LunguJean/ORCAD-Project/P1_2025_434A_Lungu_Jean_PAI_Capitolul5_N1_Simulator/P1_2025_434A_Lungu_Jean_PAI_N1_OrCAD/5_Preampl de intr.pdf

### Capitolul 5

### PREAMPLIFICATOR AUDIO DE INTRARE

Acest capitol prezintă principalele aspectele ale proiectării preamplificatorului audio de intrare destinat adaptării la intrare cu tipurile uzuale de surse de semnal, iar la ieşire cu un etaj corector de ton sau alt etaj intermediar sau chiar direct cu amplificatorul de putere.

### 5.1 TEMA DE PROIECTARE

Tema de proiectare se referă la un preamplificator de audiofrecvenţă de intrare având schema bloc prezentată în Figura 5.1-1.. Amplificatorul audio de intrare este compus din o reţea de adaptare la intrare cu principalele surse de semnale audio (microfon, pick-up cu doză magnetică, pick-up cu doză ceramică, radio, magnetofon sau alte ieşiri de semnal ale aparatelor audio electronice) şi două etaje de amplificare în clasa A, respectiv etajul de intrare şi etajul de ieşire care realizează amplificarea în tensiune a semnalului.
Amplificarea globală a amplificatorului audio de intrare este stabilită de reacţie negativă serie la intrare-paralel la ieşire iar alimentarea celor două etaje de amplificare este realizată de sursa de alimentare.

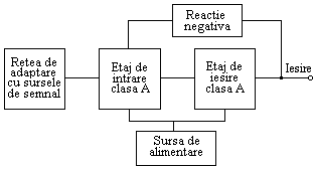
[picture p2: figure]

Figura 5.1-1. Schema bloc a amplificatorului audio de intrare

132 | Proiectarea circuitelor electronice de audiofrecvenţă

### 5.2 SETURI DE DATE DE INTRARE

Principalii parametri ai amplificatorului audio de intrare sunt: Sensibilitatea minimă la intrare Vin (mV)
Rezistenţa de intrare Ri (K )
Rezistenţa de ieşire maximă R0M (K )
Tensiunea nominală la ieşirea amplificatorului audio de putere Vn (Vef)

Sursa de alimentare va asigura următorii parametri:
Curentul nominal Io (mA)
Rezistenţa de ieşire maximă R0M ( )

Coeficientul de stabilizare
V Rs ct

V
S

I

0

0

S0min

Tensiunea de alimentare este 220Vac 10%

Tabelul 5.2-1. Seturi de date de intrare pentru proiectare
Nr. | Preamplificator | Sursa de alimentare
Vin (mV) | Ri (K ) | R0M (K ) | Vn (Vef) | Io (mA) | R0M ( ) | S0min (-)
1 | 2,5 | 47 | 3 | 1,5 | 10 | 5 | 100
2 | 5 | 47 | 3 | 1,5 | 10 | 5 | 100
3 | 100 | 100 | 3 | 1,5 | 10 | 5 | 100
4 | 200 | 1000 | 3 | 1,5 | 10 | 5 | 100
5 | 2,5 | 47 | 4 | 1,4 | 12 | 6 | 80
6 | 5 | 47 | 4 | 1,4 | 12 | 6 | 80
7 | 100 | 100 | 4 | 1,4 | 12 | 6 | 80
8 | 200 | 1000 | 4 | 1,4 | 12 | 6 | 80
9 | 2,5 | 47 | 5 | 1,3 | 14 | 7 | 60
10 | 5 | 47 | 5 | 1,3 | 14 | 7 | 60
11 | 100 | 100 | 5 | 1,3 | 14 | 7 | 60
12 | 200 | 1000 | 5 | 1,3 | 14 | 7 | 60
13 | 2,5 | 47 | 6 | 1,2 | 16 | 8 | 50
14 | 5 | 47 | 6 | 1,2 | 16 | 8 | 50
15 | 100 | 100 | 6 | 1,2 | 16 | 8 | 50
16 | 200 | 1000 | 6 | 1,2 | 16 | 8 | 50
17 | 2,5 | 47 | 7 | 1,1 | 18 | 9 | 40
18 | 5 | 47 | 7 | 1,1 | 18 | 9 | 40
19 | 100 | 100 | 7 | 1,1 | 18 | 9 | 40
20 | 200 | 1000 | 7 | 1,1 | 18 | 9 | 40

Preamplificator audio de intrare | 133

Setul de date utilizate pentru exemplificare

Pentru proiectarea etajelor amplificatorului audio de intrare a fost utilizat setul de parametri următor:

Tabelul 5.2-2. Setul de date utilizate pentru exemplificare
Nr. | Preamplificator | Sursa de alimentare
Vin (mV) | Ri (K ) | R0M (K ) | Vn (Vef) | Io (mA) | R0M ( ) | S0min (-)
1 | 2,5 | 47 | 3 | 1,5 | 10 | 5 | 100
2 | 5 | 47 | 3 | 1,5 | 10 | 5 | 100
3 | 100 | 100 | 3 | 1,5 | 10 | 5 | 100
4 | 200 | 1000 | 3 | 1,5 | 10 | 5 | 100

### 5.3 SCHEMA ELECTRONICĂ

Preamplificatorul este partea care influenţează cel mai pregnant raportul semnal zgomot, caracteristica de frecvenţă şi factorul de distorsiuni într-un lanţ de amplificare de audiofrecvenţă.
În practică există adesea şi alte semnale numite semnale false, care tind să interfereze cu semnalele dorite şi acestea se numesc în general semnale de zgomot. Un obiectiv important în proiectare este realizarea unui bun raport semnal zgomot, cu toate că zgomotul nu poate fi eliminat complet.
Un preamplificator sensibil si relativ puţin zgomotos constituie o problemă importantă dacă urmează ca la ieşire zgomotul să fie minim, deoarece orice zgomot din preamplificator este amplificat de fiecare etaj care urmează.
Din aceste considerente pentru intrarea de pick-up cu doză magnetică şi microfon dinamic la care nivelul semnalului de intrare precum şi raportul semnal zgomot sunt minime, au fost prevăzute filtre de compensare care acţionează prin intermediul sistemului de reacţie negativă, Figura 5.3-1..
Reţeaua de adaptare la intrare cu diverse surse de semnal este alcătuită din divizoarele R11, R12 pentru intrarea de radio şi magnetofon şi R13, R14 pentru intrarea de pick-up cu doză de tip piezoelectric.
Amplificarea în tensiune este realizată de etajul de intrare şi cel de ieşire. Etajul de intrare este de tipul emitor comun cu sarcină distribuită şi este realizat cu tranzistorul T1.
Etajul de ieşire este cuplat galvanic cu etajul de intrare şi este de tip emitor comun, realizat cu tranzistorul T2.
Comutarea de la o categorie de surse de semnal la alta se face prin schimbarea atenuatorilor de intrare şi a reţelei de reacţie pentru ajustarea amplificării la nivelul corespunzător.

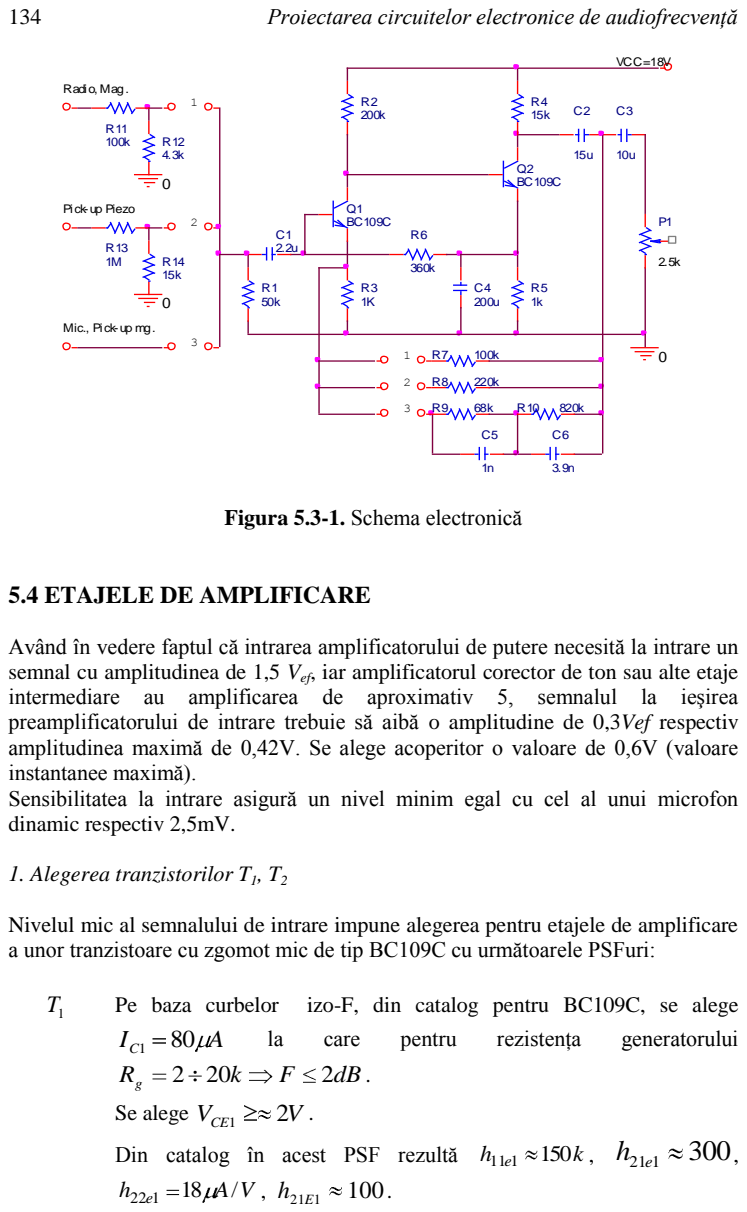
[picture p3: page 4]

Mic., Pick-up mg.

Având în vedere faptul că intrarea amplificatorului de putere necesită la intrare un
semnal cu amplitudinea de 1,5 Vef, iar amplificatorul corector de ton sau alte etaje
intermediare au amplificarea de aproximativ 5, semnalul la ieşirea
preamplificatorului de intrare trebuie să aibă o amplitudine de 0,3Vef respectiv
amplitudinea maximă de 0,42V. Se alege acoperitor o valoare de 0,6V (valoare
instantanee maximă).
Sensibilitatea la intrare asigură un nivel minim egal cu cel al unui microfon
dinamic respectiv 2,5mV.

Nivelul mic al semnalului de intrare impune alegerea pentru etajele de amplificare
a unor tranzistoare cu zgomot mic de tip BC109C cu următoarele PSFuri:

Din catalog în acest PSF rezultă

Preamplificator audio de intrare | 135

T2
Pentru T2 se alege

IC2 1mA
şi

VCE2 5V
. Din catalog în acest PSF

rezultă:

h | k 11e2
15 , | h21e2
400 ,

h22e2

55 A/V , h21E2
300 .
2. Amplificarea în tensiune

Amplificarea în tensiune a etajului de intrare care este de tipul emitor comun cu sarcină distribuită este:

3

2

1
11 2 22 1
1
R
h | h | R
A
| e | e
VT

Considerând

R | h e | h e
| | 1
2 | 11 2 | 22 1
3 | 3 | 3

1
11 2 22 1
1
15 | 55 | 12
| | R k
| R
k | k
R

h h
A
e | e
VT

Pentru obţinerea unor distorsiuni tranzitorii mici se impune o amplificare redusa, cu reacţie locală Av,T1 -10.
Din acest considerent se alege
R 1k 3

Din condiţiile:

R | h e | h e

1
2 | 11 2 | 22 1

şi

VCE1 | EC
( R2 | R3
)IC1 | 2V ,

se aleg

R 200k 2
si

EC 18V .
Se poate calcula exact VCE1:
C | 2 | C1 | B2 | CE1 | 3 C1 E | R (I | I ) V | R I
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
21 2

2
2

VCE1

18V 200k | 83 A 1k | 80 A 1,32V
şi este mai mare ca amplitudinea semnalului la ieşirea etajului de intrare. Considerând

VR2 R2

(IC1

IB2

) 16,6V
şi aproximând
VBE2 | 0,6V
VR5 | EC | VR2 | VBE2 | 0,8V .

Se alege

R5 | 1k | IC2 | 0,8mA.

Ecuaţia dreptei de sarcină pentru
2 | 4 | 5 | 2 | 2
: | ( | ) C | C | VCE T E | R | R I

, k
, mA
V | , V | V
I
E | V | V
R

C

C | R | CE | 15 25
0 8
18 | 0 8 | 5

2

5 | 2
4

,

se adoptă
R 15k 4

Amplificarea în tensiune a etajului de ieşire este:

136 | Proiectarea circuitelor electronice de audiofrecvenţă

47
55 | 15
( | ) | ( | ) | 400(15 | 18 )

11 2

1
22 1

1
21 2 | 4 | 22 2

11 2

1
21 2 | 4 | 22 2
2
k | k
k | k
h | h
h | R | h
R | h
h | R | h
A
e | e
e | e
g | e
e | e
VT

Amplificarea în tensiune a etajului de intrare este:

7,9
450

11,8 300
( | 1)
( | )

21 1
11 1 | 21 1 | 3

2

1
11 2 22 1
1
k

k
h
h | h | R
h | h | R
A | e
e | e
e | e
VT

Amplificarea în tensiune a preamplificatorului în buclă deschisă este:

AV | AVT1 AVT2
| | 7,9 47 371
3. Impedanţa de intrare

Impedanţa de intrare în buclă deschisă a preamplificatorului este:

1 | 11 1 | 21 1 | 3 | 6 ZInT | (h e
(h e | 1)R ) | R
R6
se dimensionează având în vedere necesitatea polarizării bazei tranzistorului T1
:
R6
IB1 | VR5 | VBE,T1 | VR3

0,8 0,43 0,08 0,29V

cu
A
h

I
I

E

C
B | 0,8
100

80

21 1

1
1

K
A

V
R | 362
0,8

0,29
6

se alege
R 360k 6

ZInT1

(150K 300K) | 360K | 200K
4. Dimensionarea condensatorilor

Din motive de stabilitate determinate grafic pe caracteristica BODE, se alege pentru polul dat de

C4
la frecvenţa
5 10 | (7 | ) f
4 | Hz Hz p

Rezistenţa văzută la bornele lui

C4
este:

1 126
400

15 43

21 2

1
11 2 | 2 | 22 1
4 | 5 | K
k | K
h
h | R | h
R | R
| e
e | e
C p

F
f R

C

p C p

180
2

1

4 | 4

4

, se alege
C4

200 F

Având în vedere că

R1
se alege astfel încât impedanţa văzută spre amplificator să fie

47k
, necesară pentru adaptarea cu doza magnetică şi alegând f 1,5Hz 1

Preamplificator audio de intrare | 137

, F
,
C | 2 2
2 15 47 10

1

1 | 3

Pentru dimensionarea C2 se apreciază că impedanţa la bornele sale nu va fi mai mică de 50K având în vedere efectul potenţiometrului de balans şi al reţelei de reacţie. Se alege
f 0,2Hz 2

, F
f R

C

C

15 9
2

1

2 | 2

2

, se alege

C2 15 F .

Impedanţa de ieşire a preamplificatorului fără reacţie negativă este:
Z | R | h | k | k | k IesT | e
15 | 18 | 8,2

1
2 | 4 | 22 2
Cu reacţie negativă având în vedere necesitatea de amplificare pentru o valoare medie r = 100⁻¹
,

Impedanţa de ieşire
, K
,

, K
A

Z
Z

r u

IesT
Ies | 2 2
3 71

2 8 2

Se poate accepta ca valoare minima a lui

P1
25
K , valoarea maximă de
aproximativ 100 K e impusă de intrarea în circuitul corector de ton. Valoarea lui

C3
s-a ales de
C3 10 F

pentru P1 =25 K .

### 5.5 REACŢIA NEGATIVĂ ŞI REŢELELE DE ADAPTARE

Pentru estimarea nivelului nominal al semnalului la ieşirea preamplificatorului cunoaştem:
Amplitudinea nominală a semnalului la intrarea în amplificatorul final
Vnom. aap = 1,5Vef
Amplificarea circuitelor intermediare de aproximativ 5
Atenuarea introdusă de P1 = 0,9

ef

ef
iesire pa | mV

V
V | 330
5 0,9

1,5

,

Reţelele de adaptare se dimensionează în raport cu acest nivel şi nivelele tipice ale surselor de program. S-au adoptat următoarele categorii de surse de semnal corespunzătoare cu tema de proiectare:

Tabelul 5.5-1. Caracteristicile surselor de semnal uzuale
Sursa | Rezistenţa de intrare Ri (K ) | Sensibilitate Vin (mV)
Radio, magnetofon | 100K | 100mVef
Pick-up ceramic | 1M | 200mVef
Pick-up magnetic | 47K | 5mVef, la 1KHz
Microfon | 47K | 2,5mVef

138 | Proiectarea circuitelor electronice de audiofrecvenţă

Alegerea reţelei de reacţie serie la intrare–paralel la ieşire creşte impedanţa de intrare şi micşorează impedanţa de ieşire, apropiind preamplificatorul audio de intrare de un amplificator ideal de tensiune. Experimental pentru un răspuns tranzitoriu bun

50 ¹
r
Dimensionarea reţelei de reacţie şi a reţelei de adaptare:
1. Dimensionarea pentru poziţia radio-magnetofon

Pentru poziţia radio-magnetofon se alege

R 100k 7
transferul pe bucla de
reacţie r=100⁻¹
, iar amplificarea cu reacţie este:

79
1 3,71

371

1 | r | V
| V
VR | A

A
A | .

Nivelul semnalului de intrare in preamplificator este:
mV mV UInT | 4,2
79

330

1
Deoarece nivelul semnalului la intrare pentru această sursă de semnal este Uin=100mV raportul de divizare al rezistenţelor R11, R12 este:

23
4,2

100

12 | 1

11

12

11 12
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
Deoarece

Z | k in | 100
, se alege
R | 100k 11 | 4,3 | .
12 R | k
2. Dimensionarea pentru poziţia microfon şi pick-up ceramic

Pentru poziţia microfon şi pick-up ceramic se utilizează reţeaua de reacţie, . R8 R3
Amplificatorul se calculează pentru nivelul minim de intrare dat de microfon:

132
2,5

330

1 | int | mV mV
| V V
A

A
A

rare

iesire

r V

V
VR | 221
| 1
4,5 10
132
132 | 3

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
r | 221 ³
8
8

3

8 | 3

3
. Se alege

R 220k 8

Dimensionarea divizorului de intrare pentru pick-up ceramic.

80
2,5

200

14 | , 1

13
mV

mV
V

V
R

R

In T

In

Din condiţia ca impedanţa de intrare să fie de aproximativ 1M , se alege
R13 | 1M | R | 12,5k 14
. Se alege

R 18k 14

Preamplificator audio de intrare | 139
3. Dimensionarea pentru poziţia microfon şi pick-up magnetic

Pentru intrarea de microfon şi pick-up magnetic se proiectează o reţea de reacţie egalizatoare, care să corecteze caracteristica de frecvenţă a dozei magnetice. S-a adoptat corecţia după norma R.I.A.A, în care se impun următoarele constante de timp: t1=318 s, t2=75 s, t3=3180 s.
Considerând o reacţie suficient de puternică astfel încât să se poată scrie:

r

AVr

1
şi având
Z

R

r

3
, unde Z( ) este impedanţa grupului format din R9,

R10, C5, C6
( )

3

K Z
R

Z
AVr

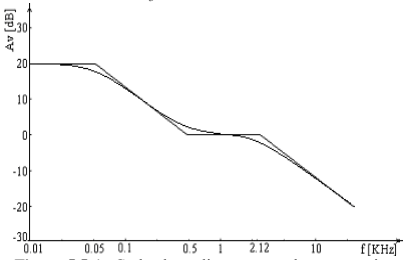
[picture p4: figure]

Figura 5.5-1. Curba de egalizare pentru doză magnetică

Z( ) este de forma:
(1 | )(1 | )

1

2 | 3

1
pt pt

pt
Z | B | ,

unde:
3 | 6 | 10
9 | 10
9 | 10
9 | 10 | 2 | 5 | 9 | 1 | 5 | 6
; | ; | ( | ) | ; t | C R
R | R

R R
B | R | R | t | C R | t | C | C

şi

10 | 9 | 6 | 4 5 R | 11,8R ; C | 3, C .

Practic la 1KHz se poate considera

Z R9
şi atunci

3

9
,1
R

R
AVr KHz

Amplificarea necesară este: 66
5

330

,1 | mV
mV AVr KHz R | R A | k 9 | 3 | Vr,1KHz | 66 | .

Se adoptă

R9 | 68K | R10 | 11,8R9 | 803K .

Se adoptă

R10 820K .

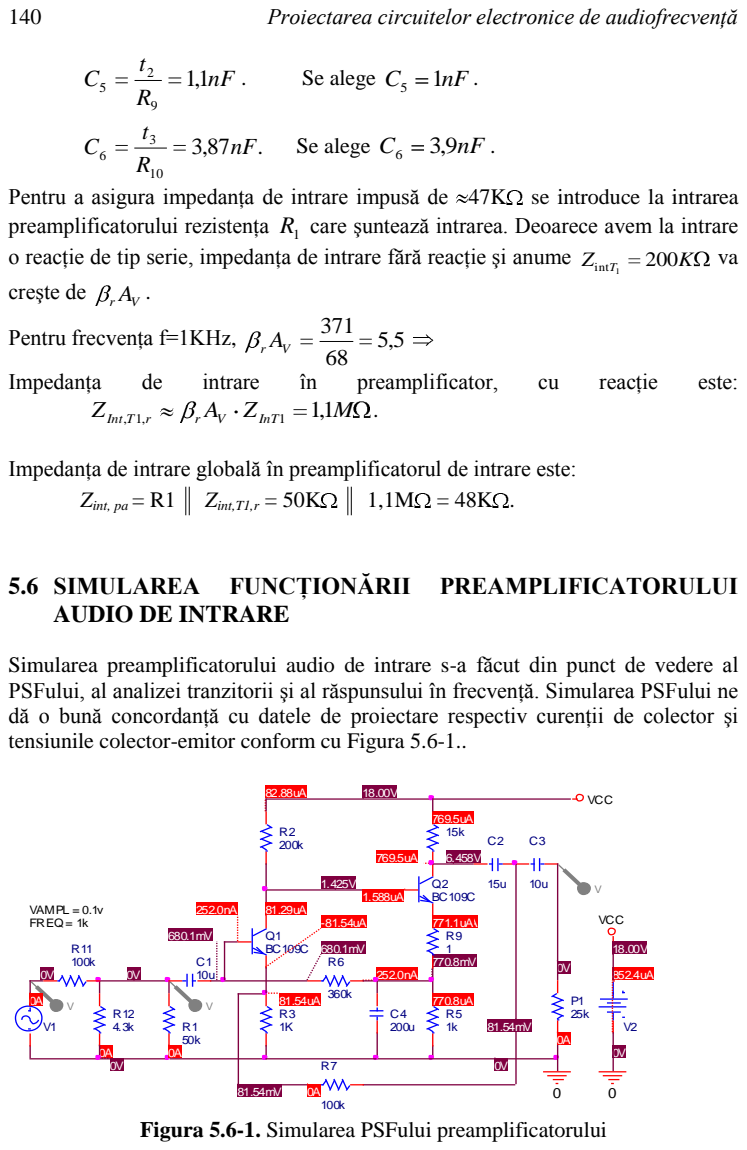
[picture p5: page 10]

preamplificatorului rezistenţa
o reacţie de tip serie, impedanţa de intrare fără reacţie şi anume
creşte de

care şuntează intrarea. Deoarece avem la intrare

Impedanţa de intrare globală în preamplificatorul de intrare este:

Simularea preamplificatorului audio de intrare s-a făcut din punct de vedere al
PSFului, al analizei tranzitorii şi al răspunsului în frecvenţă. Simularea PSFului ne
dă o bună concordanţă cu datele de proiectare respectiv curenţii de colector şi
tensiunile colector-emitor conform cu Figura 5.6-1..

Figura 5.6-1. Simularea PSFului preamplificatorului

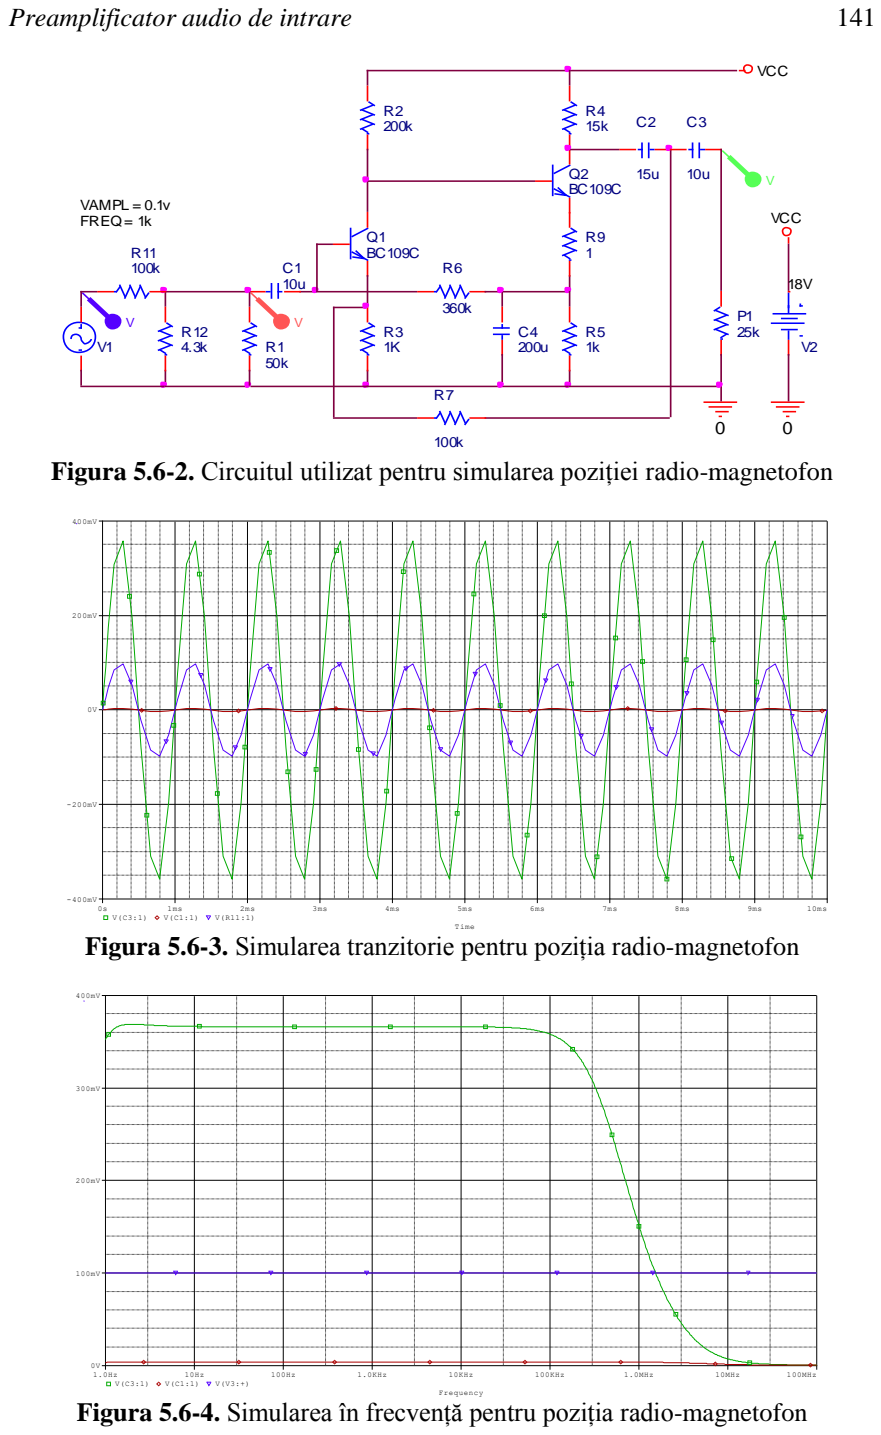
[picture p6: page 11]

Figura 5.6-2. Circuitul utilizat pentru simularea poziţiei radio-magnetofon

Figura 5.6-3. Simularea tranzitorie pentru poziţia radio-magnetofon

Figura 5.6-4. Simularea în frecvenţă pentru poziţia radio-magnetofon

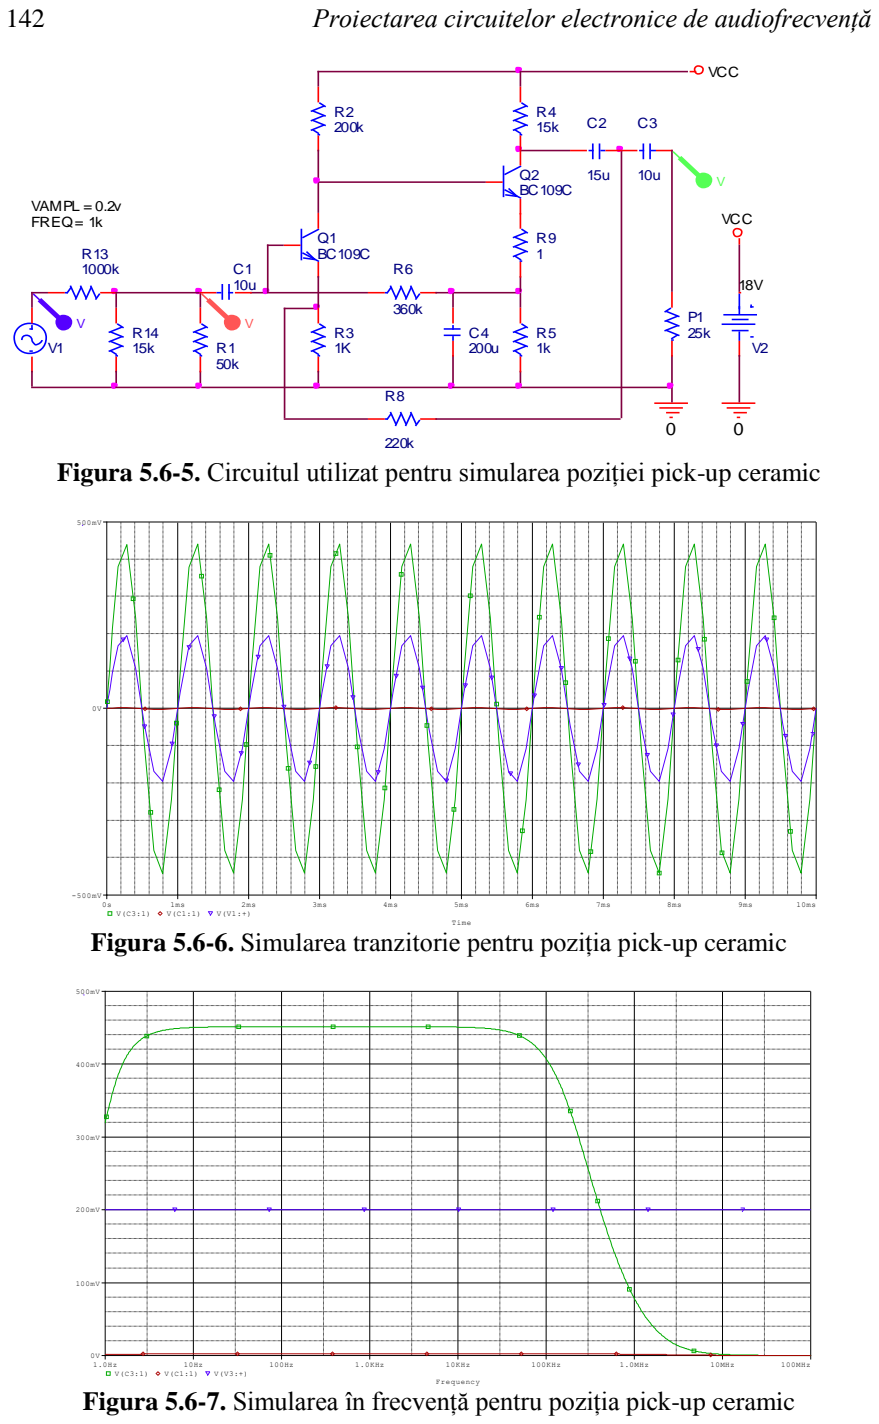
[picture p7: page 12]

Figura 5.6-5. Circuitul utilizat pentru simularea poziţiei pick-up ceramic

Figura 5.6-6. Simularea tranzitorie pentru poziţia pick-up ceramic

Figura 5.6-7. Simularea în frecvenţă pentru poziţia pick-up ceramic

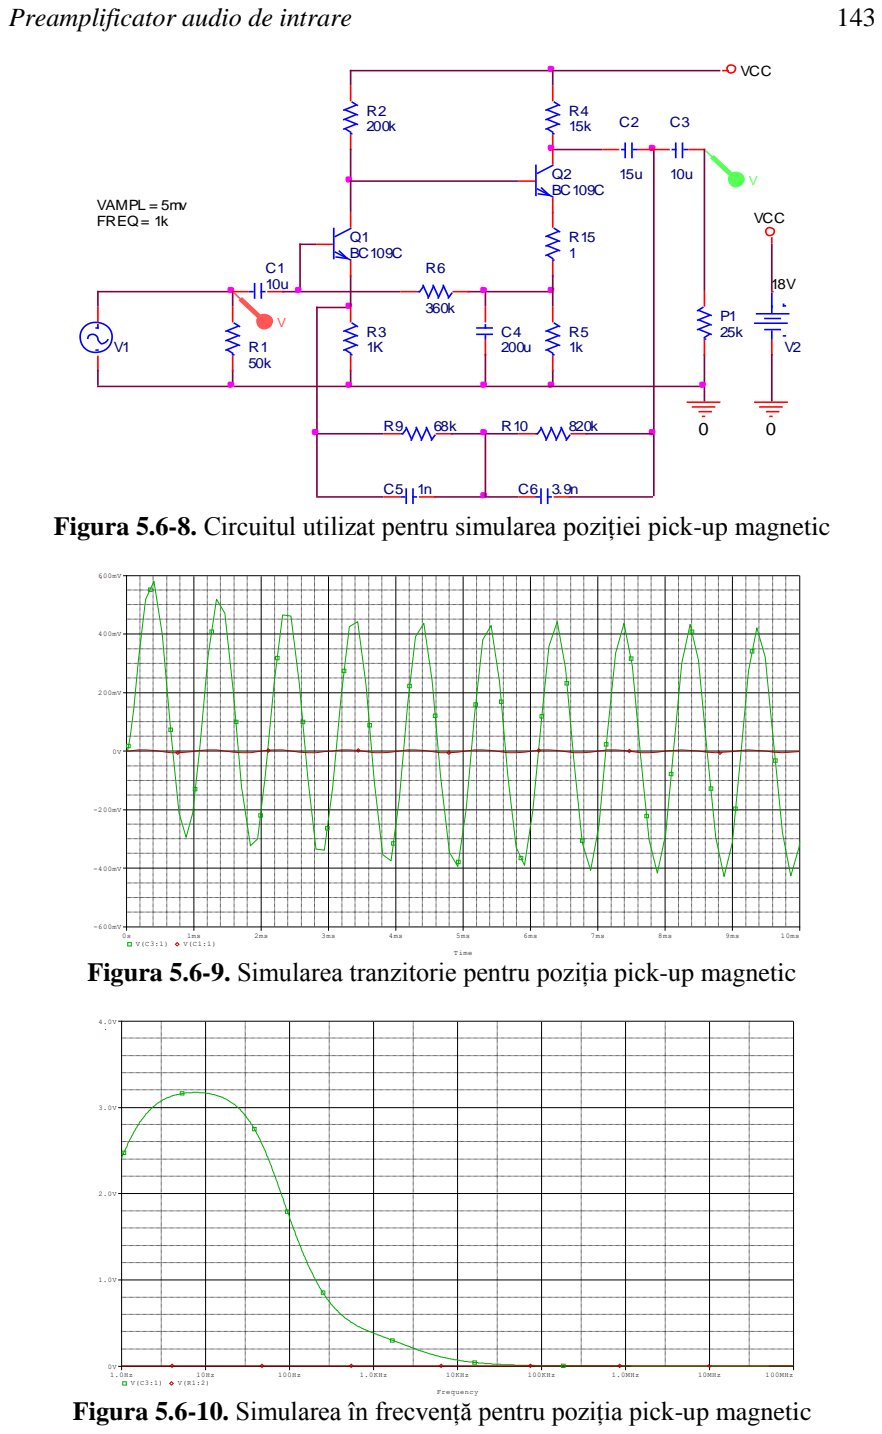
[picture p8: page 13]

Figura 5.6-8. Circuitul utilizat pentru simularea poziţiei pick-up magnetic

Figura 5.6-9. Simularea tranzitorie pentru poziţia pick-up magnetic

Figura 5.6-10. Simularea în frecvenţă pentru poziţia pick-up magnetic

144 | Proiectarea circuitelor electronice de audiofrecvenţă

### 5.7 SURSA DE ALIMENTARE

Alimentarea preamplificatorului audio şi a celui corector de ton se face din aceeaşi sursă.

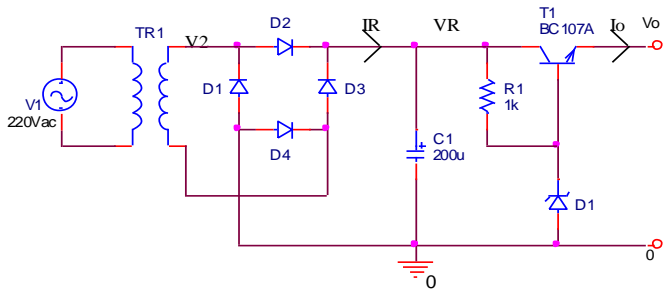
[picture p9: figure]
V1 220Vac

Figura 5.7-1. Sursa de alimentare a preamplificatorului audio

Conform temei de proiectare variaţiile tensiunii de alimentare sunt

10%
. Pentru
o tensiune medie la ieşirea redresorului VR=30V tensiunea maximă la ieşirea redresorului şi tensiunea minimă la ieşirea redresorului sunt VRM=33V şi VRm=27V.
Curentul de alimentare pentru două canale de preamplificare şi celelalte etaje intermediare se estimează la 10mA.

Proiectarea stabilizatorului

1. Alegerea tranzistorului regulator serie

Se alege tranzistorul T1=BC107A cu PSFul IC=10mA şi VCE=5V pentru care h21e 100.

2. Alegerea diodei stabilizatoare

Se alege dioda PL12V care are

I min | 2mA, PM | 100mW
| | | | | | | şi RZ=5 .
Se | conectează | în | serie | 2 | diode | şi se | consideră curentul maxim
admisibil
| I Max adm | | 9mA
, iar pentru curentul minim se alege

I min 3mA.
Din considerente de stabilitate a PSFului se verifică polarizarea bazei tranzistorului regulator serie T1.
B | dioda
E
C | mA | I

m
I
h

I
| 0,1
100

10

21

3. Dimensionarea rezistenţei R1

Dimensionarea rezistenţei R1 se face astfel ca la tensiunea de intrare minimă

Preamplificator audio de intrare | 145

aceasta să asigure funcţionarea diodei zener.

k
I | mA

V
R

Z min

min | 1
3

27 24

1

În condiţiile în care tensiunea de intrare este maximă, curentul prin dioda zener nu trebuie să depăşească curentul maxim admisibil.

mA
R | k

V
I

max
Z max | 9
1

33 24
=IMax adm=9mA.
4. Verificarea puterii disipate de tranzistorul regulator serie T1

Pentru verificarea puterii disipate de T1, în cazul cel mai defavorabil calculăm tensiunea colector-emitor când prin diodă trece curentul maxim de 10mA. În această situaţie tensiunea pe rezistenţa R1 esteVR1=9V. Deoarece VCB=VR VCE=VR+VBE=9,7V
Pd = VCE | IC = 97mW | 300mW.
5. Coeficientul de stabilizare cu tensiunea

Deoarece Vo= Vi
1
1 | 1
| 1

1
R
g | h | R
| | Z
m | oe

Vi
1

1

1
R

R

Z

V Rs ct

V
S

I

0

0 | 1

1
R

R

Z

=101

6. Rezistenţa de ieşire a stabilizatorului

Ro=
1
hie1 | R | RZ
1

hie1 RZ

40 10

100
40 1

1
I

h
C

ie

=0,25K

Ro=
101

250 10
=2,6

Proiectarea redresorului

1. Dimensionarea punţii redresoare

Pentru dimensionarea punţii redresoare calculăm tensiunea inversă şi curentul maxim prin aceasta:

146 | Proiectarea circuitelor electronice de audiofrecvenţă
Vinv | 1,5VR max | 50V
I max | 3,5I R max | 3,5 I 0 | I ZMax | 3,5(10 9) 67mA
Se alege o punte 1PM1 cu tensiunea inversă de 100V şi curentul mediu redresat de 1,2A.
2. Dimensionarea condensatorului de filtraj

Condensatorul de filtraj C1 se dimensionează utilizând inegalitatea:

R

R
V

, I
C

0 3
1 | F
V
, | mA
C | 160
30

0 3 16

1

Se alege C1 = 200 F/50V

3. Estimarea tensiunii şi curentului în secundarul transformatorului

Estimarea tensiunii şi curentului în secundarul transformatorului este necesară pentru dimensionarea numărului de spire şi diametrul înfăşurării secundare a transformatorului.

530

2
2 | 0 75
I ( R | | R )
V | , V
R | i | T
R

, unde:

Ri este rezistenţa corespunzătoare diodelor din puntea redresoare RT este rezistenţa corespunzătoare tranzistorului regulator serie R0 este rezistenţa de ieşire a redresorului

R

R
T
I

V
R ( 0,06 0,04 )R0

, R0

, V

mA V | , | V | 22 5
530
16 | 100
2 | 0 75 30
i | T

R
R
R R

, V
I | , | I
| | 2 16 6
2 | 1 41 | I
2 | 27,4mA

### 5.8 LISTA COMPONENTELOR

Lista componentelor amplificatorului audio de intrare

Rezistenţe

R1 = 50K | 5% | R2 = 200K | 5%
R3 = 1K | 2,5% | R4 = 15K | 5%
R5 = 1K | 5% | R6 = 360K | 5%

Preamplificator audio de intrare | 147
R7 = 100K | 2,5% | R8 = 220K | 2,5%
R9 = 68K | 2,5% | R10 = 820K | 2%
R11 = 100K | 2,5% | R12 = 4,3K | 2,5%
R13 = 1M | 2,5% | R14 = 13K | 2,5%
P1 = 25K | | EC = 18V

Condensatori

C1 = 2,2 F / 10V | C2 = 15 F / 15V
C3 = 10 F / 15V | C4 = 200 F / 10V
C5 = 1nF | 5% | C6 = 3,9nF | 5%

Tranzistori

T1, T2 = BC109C

Lista componentelor stabilizatorului

Rezistenţe | | Condensatori
R1 = 1 K | 5% | C1 = 200 F / 50V
Transformator monofazat | Punţi redresoare
V2 = 22,5V | | 1PM1

I2 = 30mA
