LunguJean/ORCAD-Project/P1_2025_434A_Lungu_Jean_PAI_Capitolul5_N1_Simulator/P1_2025_434A_Lungu_Jean_PAI_N1_OrCAD/Proiect docs/Documentatie_Proiect1_APD.pdf

Universitatea “Politehnica” din Bucuresti Facultatea de Electronica, Telecomunicatii si Tehnologia Informatiei

## PREAMPLIFICATORUL AUDIO DE INTRARE CAPITOLUL 5 Lungu Jean

434Aa

1.Tema de proiectare

Tema de proiectare se referă la un preamplificator de audiofrecvenţă de intrare având schema bloc prezentată în Figura 5.1-1. Amplificatorul audio de intrare este compus din o reţea de adaptare la intrare cu principalele surse de semnale audio (microfon, pick-up cu doză magnetică, pick-up cu doză ceramică, radio, magnetofon sau alte ieşiri de semnal ale aparatelor audio electronice) şi două etaje de amplificare în clasa A, respectiv etajul de intrare şi etajul de ieşire care realizează amplificarea în tensiune a semnalului. Amplificarea globală a amplificatorului audio de intrare este stabilită de reacţie negativă serie la intrare-paralel la ieşire iar alimentarea celor două etaje de amplificare este realizată de sursa de alimentare.

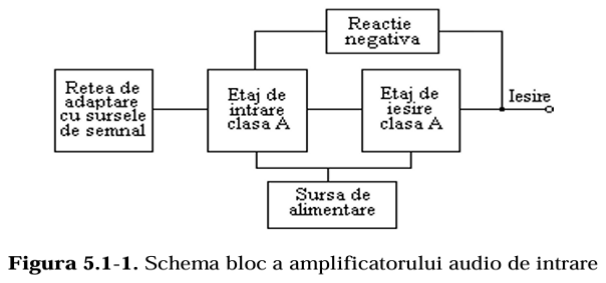
[picture p10: figure]

2.Seturi de date de intrare

Principalii parametri ai amplificatorului audio de intrare sunt:

- Sensibilitatea minimă la intrare Vin (mV)
- Rezistenţa de intrare Ri (K )
- Rezistenţa de ieşire maximă R0M (K )
- Tensiunea nominală la ieşirea amplificatorului audio de putere Vn (Vef) Sursa de alimentare va asigura următorii parametri:
- Curentul nominal Io (mA)
- Rezistenţa de ieşire maximă R0M (ohm )

- Coeficientul de stabilizare
- Tensiunea de alimentare este 220Vac+/- 10%

Seturi de date de intrare:
Nr. crt | Vin (mV) | Rin [ kΩ ] | R0m [ kΩ ] | Vn [ Vef ]
1 | 2.5 | 47 | 3 | 1.5

3.Schema electrica

Preamplificatorul este partea care influenţează cel mai pregnant raportul semnal zgomot, caracteristica de frecvenţă şi factorul de distorsiuni într-un lanţ de amplificare de audiofrecvenţă.
În practică există adesea şi alte semnale numite semnale false, care tind să interfereze cu semnalele dorite şi acestea se numesc în general semnale de zgomot. Un obiectiv important în proiectare este realizarea unui bun raport semnal zgomot, cu toate că zgomotul nu poate fi eliminat complet.
Un preamplificator sensibil si relativ puţin zgomotos constituie o problemă importantă dacă urmează ca la ieşire zgomotul să fie minim, deoarece orice zgomot din preamplificator este amplificat de fiecare etaj care urmează.
Din aceste considerente pentru intrarea de pick-up cu doză magnetică şi microfon dinamic la care nivelul semnalului de intrare precum şi raportul semnal zgomot sunt minime, au fost prevăzute filtre de compensare care acţionează prin intermediul sistemului de reacţie negativă,
Amplificarea în tensiune este realizată de etajul de intrare şi cel de ieşire. Etajul de intrare este de tipul emitor comun cu sarcină distribuită şi este realizat cu tranzistorul T1. Etajul de ieşire este cuplat galvanic cu etajul de intrare şi este de tip emitor comun, realizat cu tranzistorul T2.

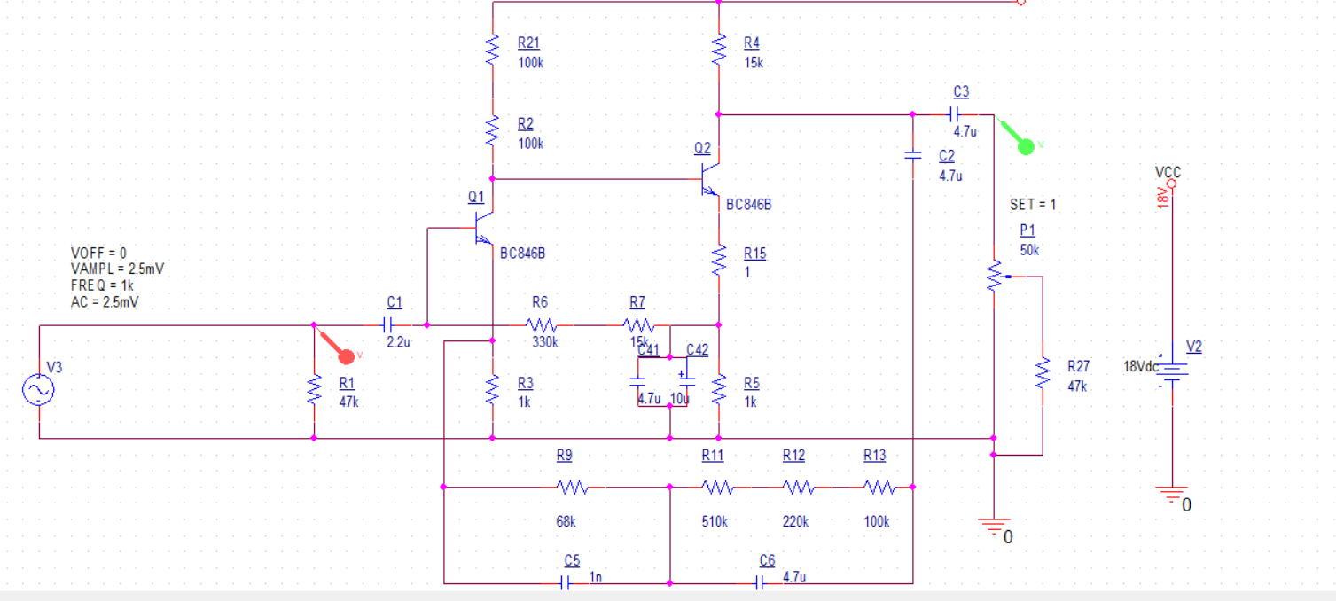
[picture p11: figure]

Fig 2 Schema electrica

4.Etajele de amplificare

Având în vedere faptul că intrarea amplificatorului de putere necesită la intrare un semnal cu amplitudinea de 1,5 Vef, iar amplificatorul corector de ton sau alte etaje intermediare au o amplificare de aproximativ 5, rezultă că semnalul la ieșirea preamplificatorului de intrare trebuie să aibă o amplitudine de aproximativ 0,3 Vef, respectiv 0,42 V (valoare instantanee maximă).

S-a ales acoperitor o valoare de 0,6 V.

1.Alegerea tranzistorilor T1 si T2
Nivelul mic al semnalului de intrare impune alegerea pentru etajele de amplificare a unor tranzistoare cu zgomot mic de tip BC846B cu PSFurile: T1: Pe baza curbelor izo-F, din catalog pentru BC846B, se aleg IC1=80μA la care pentru rezistenţa generatorului Rg=2÷20k⇒F≤2dB.

Se alege VCE1≥≈2V ( 1.44V in simulare).
Din catalog în acest PSF rezultă:
| h₁₁e1 = rbe ≈ 150 kΩ
| h₂₁e1 = β ≈ 300

h₂₂e1 = 0.1 μS
T2: | Ic2 = 800uA și VCE2 ≈ 5V
| Din catalog în acest PSF rezultă:
| h₁₁e2 = rbe ≈ 15 kΩ
| h₂₁e2 = hFE = β ≈ 300
| h₂₂e2 = 0.05 μS

2.Amplificarea în tensiune
| Nota: R2 este format din R2 + R21, R6 = R6+R7, R10=R11+R12+R13.
Amplificarea în tensiune a etajului de intrare care este de tipul emitor comun cu
| sarcină distribuită este:

Pentru tranzistorul BC846B, în regimul ales, folosim aproximativ:

- h21e1 ≈300
- (h22e1)−1 ≈300kΩ

Considerăm:

Calculăm sarcina distribuită:

Introduce în relația amplificării:

Pentru obţinerea unor distorsiuni tranzitorii mici se impune o amplificare redusa, cu reacţie locală AvT1 = -10.

Din condiţiile:

se aleg R2 = 200kΩ si EC =18V

Tensiunea colector-emitor:

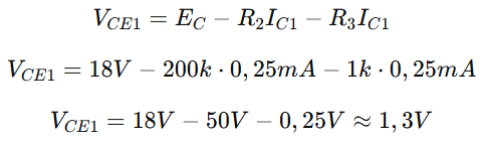
[picture p12: figure]

şi este mai mare ca amplitudinea semnalului la ieşirea etajului de intrare. Considerând:

şi aproximând VBE = 0.65 =>

Se alege R₃ = 1 kΩ, deci IC1 ≈0,75mA. Ecuația dreptei de sarcină pentru Q₂:

Alegem R₄ = 15 kΩ deoarece este cea mai apropiată valoare. Se alege R5 = 1 kΩ => Ic2 = 0,8mA
Amplificarea în tensiune a etajului de ieșire este:

Amplificarea în tensiune a etajului de intrare este:

Amplificarea în tensiune a preamplificatorului în buclă deschisă este:

3.Impedanta de intrare
Impedanța de intrare în buclă deschisă a preamplificatorului este:

Rezistența de intrare se dimensionează având în vedere necesitatea polarizării bazei tranzistorului T₁:

Considerand VR6 ≈0,29V, rezultă:

Rezistența de intrare totală ținând cont de R₁ = 47kΩ este Rin ≈47kΩ, exact Rin din setul de date.

4.Dimensionarea condensatoarelor
Din motive de stabilitate determinate grafic pe caracteristica Bode, se alege pentru polul dat de C₄ frecvența f4p ≈5÷10Hz.
Rezistența văzută la bornele lui C₄ este:

Se alege C₄ conform gruparii in paralel a lui C41 si C42.

Pentru C₁ se alege astfel încât impedanța văzută spre amplificator să fie:

Se alege C₁ = 2,2 µF (valoare disponibilă SMT).
Pentru dimensionarea lui C₂ se consideră impedanța la bornele sale:

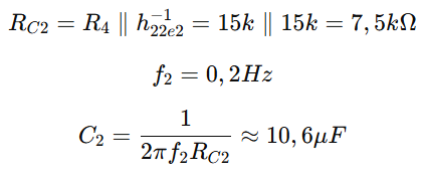
[picture p13: figure]

Se alege C₂ = 4,7 µF, iar pentru simetrizare s-a păstrat și C₃ = 4,7 µF. Impedanța de ieșire a preamplificatorului fără reacție negativă este:

Cu reacție negativă având în vedere necesitatea de amplificare pentru o valoare medie βr =(100)−1, se obține impedanța de ieșire:

Se poate accepta ca valoare minima a rezistorului P1=50kΩ, valoarea maximă de aproximativ 100kΩ e impusă de intrarea în circuitul corector de ton. Valoarea lui C3 s-a ales C3=4.7μF pentru P1 =50kΩ.
5.Reactia negativa si retelele de adaptare

Pentru estimarea nivelului nominal al semnalului la ieșirea preamplificatorului cunoaștem:

- Amplitudinea nominală a semnalului la intrarea în amplificatorul final Vnom,aap =1,5Vef
- Amplificarea circuitelor intermediare de aproximativ 5
- Atenuarea introdusă de potențiometrul P1, pentru P1 = 50kΩ, aproximată la α=0,9
- Rezultă pentru nivelul semnalului la ieșirea preamplificatorului:

Rețelele de adaptare se dimensionează în raport cu acest nivel și nivelele tipice ale surselor de program.

Sursa | Rezistența de intrare Ri [kΩ] | Sensibilitate Vin [mV]
Microfon | 47 | 2,5

Pentru poziția microfon se utilizează rețeaua de reacție formată din rezistențele R₆ = 345 kΩ și R₈ = 220 kΩ, astfel încât să se asigure amplificarea necesară
pentru nivelul minim al semnalului de intrare.
Nivelul nominal la ieșirea preamplificatorului, necesar atacării corectorului de ton, este Viesire =0,33Vef .
Pentru microfon se cunoaște sensibilitatea Vin =2,5mVef .
Amplificarea necesară în buclă închisă este :

Coeficientul de reacție negativă pentru divizorul format de R₆ și R₈ este:

Amplificarea preamplificatorului în buclă deschisă este Av =220. Amplificarea în buclă închisă este:

Cum nivelul real de la ieșire este Viesire =Av,r ⋅Vin =1,63⋅2,5mV=4,1mV.
se introduce divizorul de intrare R₁ = 47 kΩ, care asigură aducerea semnalului la valoarea necesară etajului de intrare, astfel încât amplificarea totală a preamplificatorului pentru poziția microfon să atingă valoarea cerută Av,total =132.

5.Simularea Functionalitatii

Simularea preamplificatorului audio de intrare s-a făcut din punct de vedere al PSFului, al analizei tranzitorii şi al răspunsului în frecvenţă. Simularea PSFului ne dă o bună concordanţă cu datele de proiectare respectiv curenţii de colector şi tensiunile colector-emitor

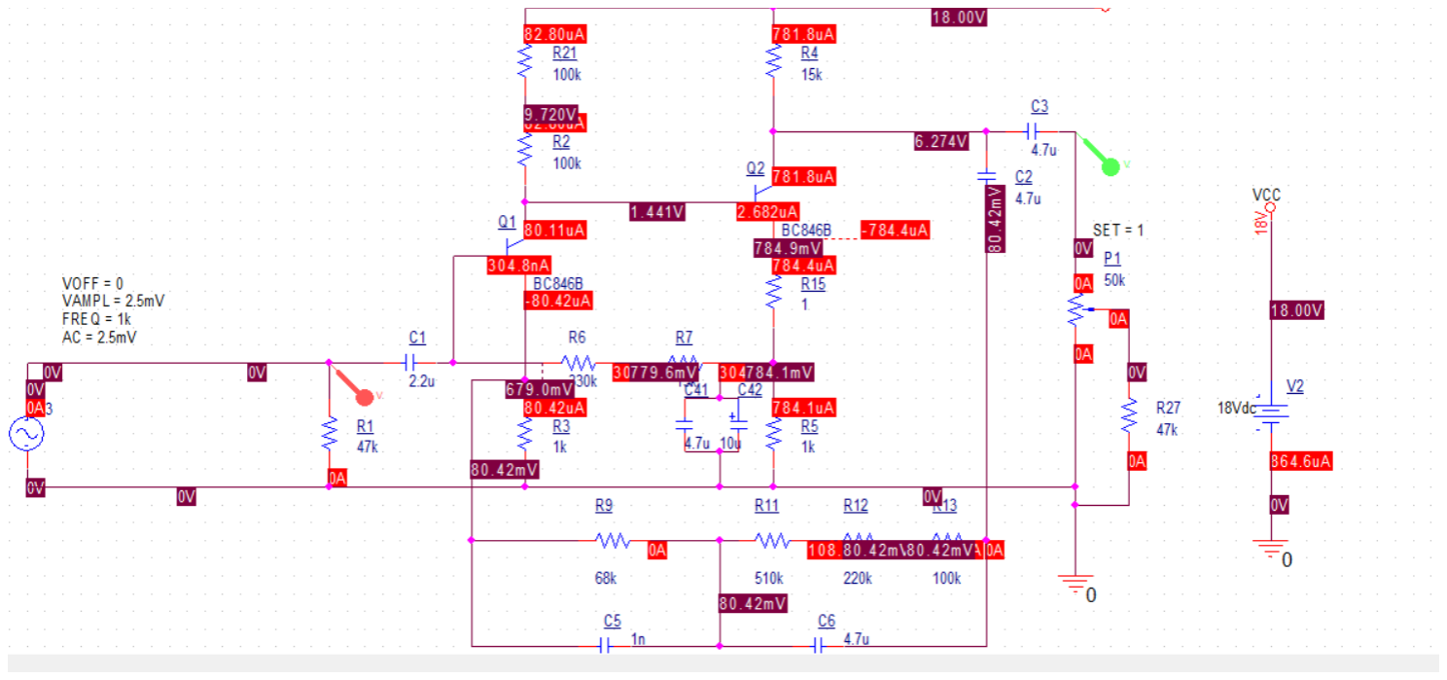
[picture p14: figure]

Simulare tranzitorie

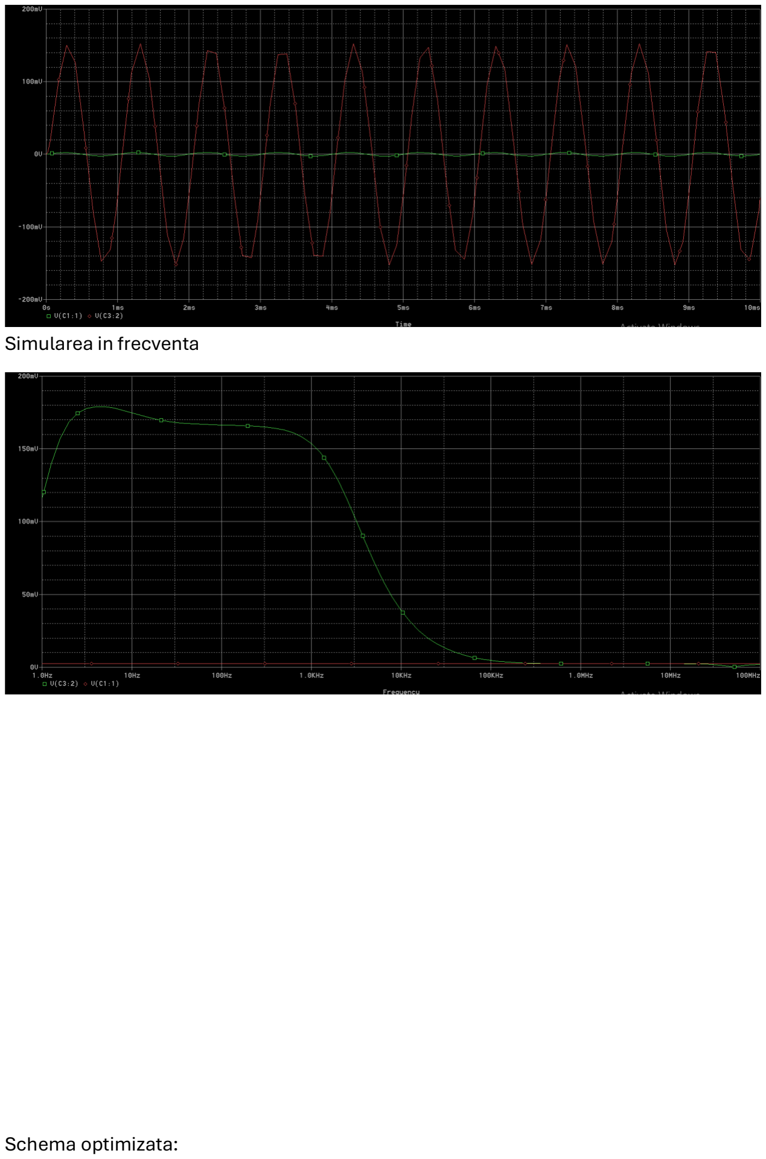
[picture p15: page 11]

Simularea in frecventa

Schema optimizata:

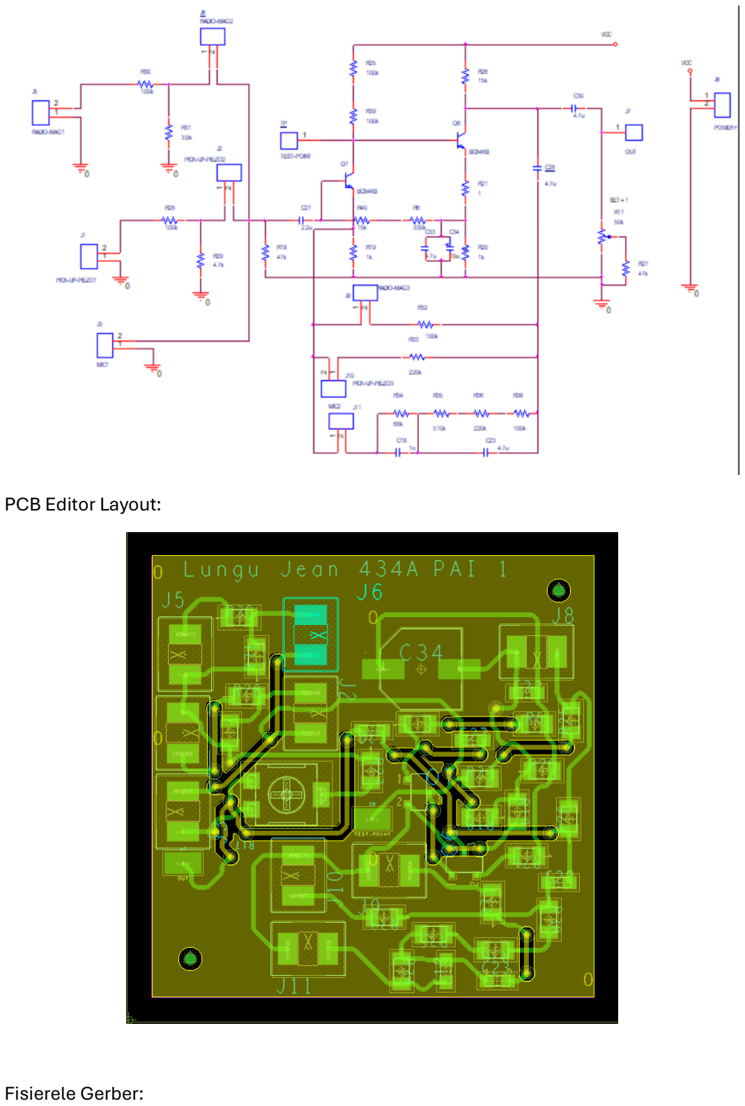
[picture p16: page 12]

PCB Editor Layout:

Fisierele Gerber:

-BO.art

-BOTTOM.art

-DRILL.drl

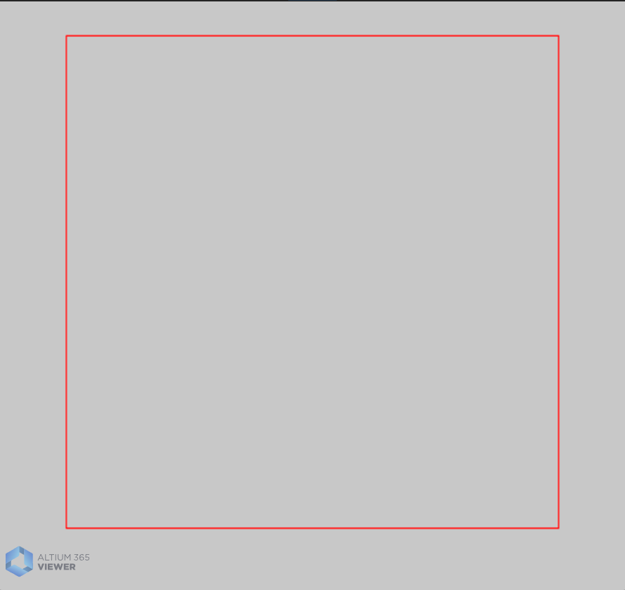
[picture p17: figure]
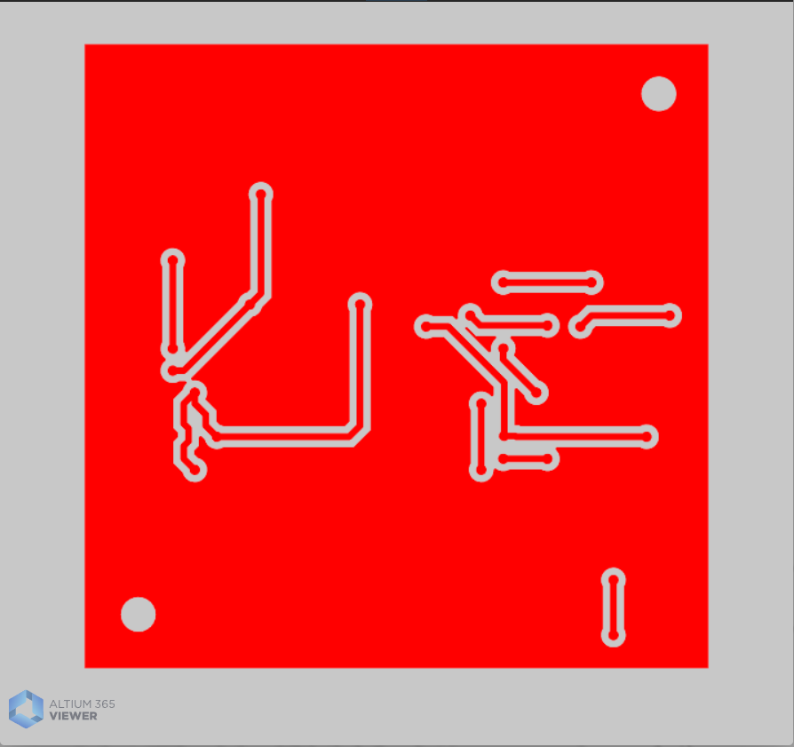
[picture p18: figure]

-FAB.art

-SMBOT.art

-SMTOP.art

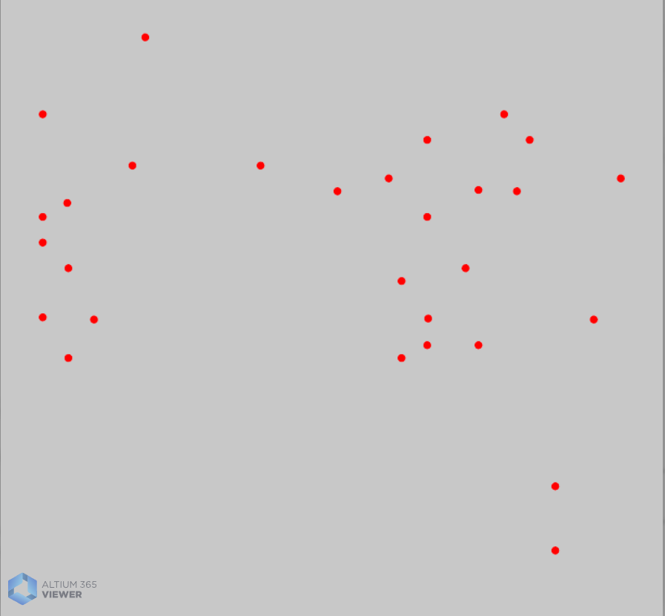
[picture p19: figure]
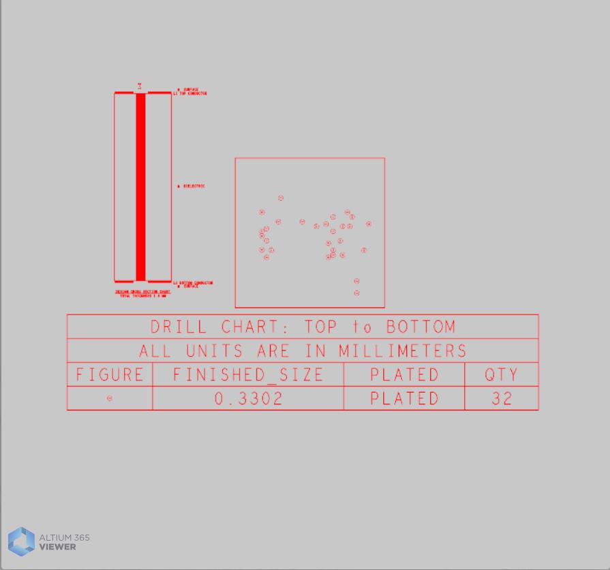
[picture p20: figure]
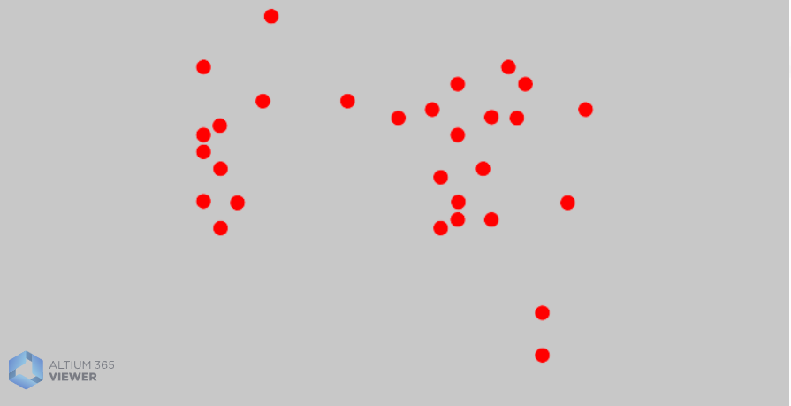
[picture p21: figure]

-SPTOP.art

-SSTOP.art

-TOP.art

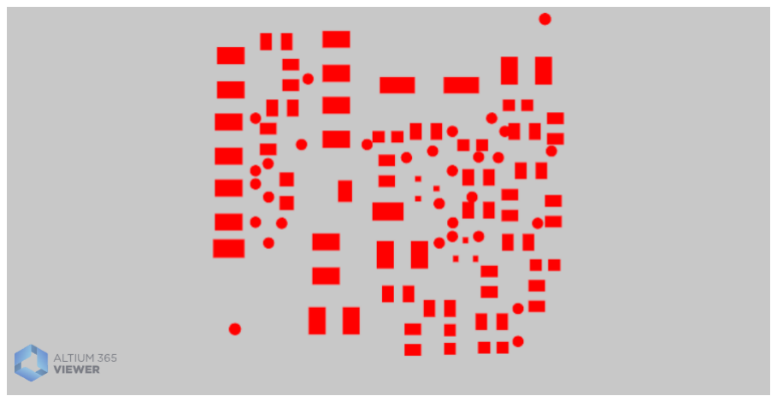
[picture p22: figure]
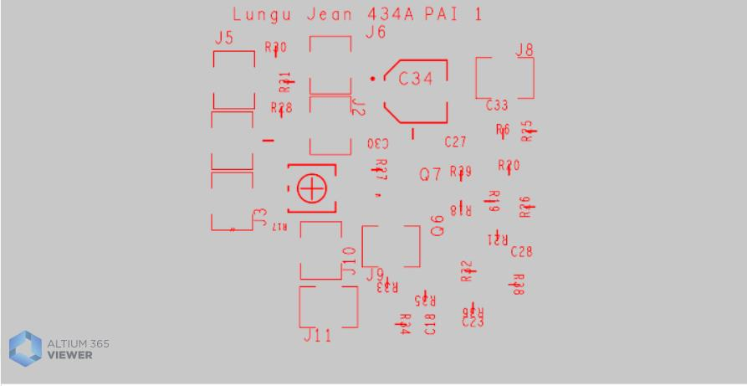
[picture p23: figure]
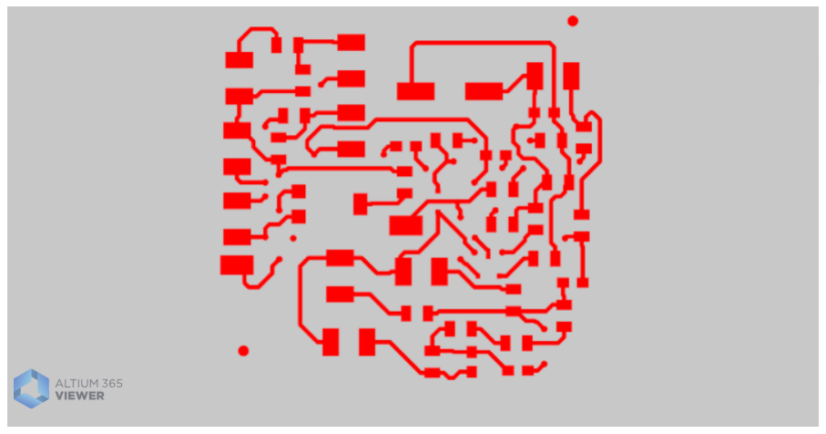
[picture p24: figure]

6.Lista componentelor

Rezistente:
R1=47K
R2=100K

R3=1K
R4=15k
R5=1k
R6=330k
R7=15k
R9=68k
R11=510k
R12=220k
R13=100k
R15=1
R21=100k
R27=47k
Condensatoare:
C1=2.2u
C2=4.7u
C3 = 4.7u
C5 = 1n
C6 = 4.7u
C41 = 4.7u
C42 =10u
Potentiometrul P1 = 50k
Tranzistoarele T1 si T2
