LunguJean/ORCAD-Project/P1_2025_434A_Lungu_Jean_PAI_Capitolul5_N1_Simulator/P1_2025_434A_Lungu_Jean_PAI_N1_OrCAD/Simulations/Simularea 1.png

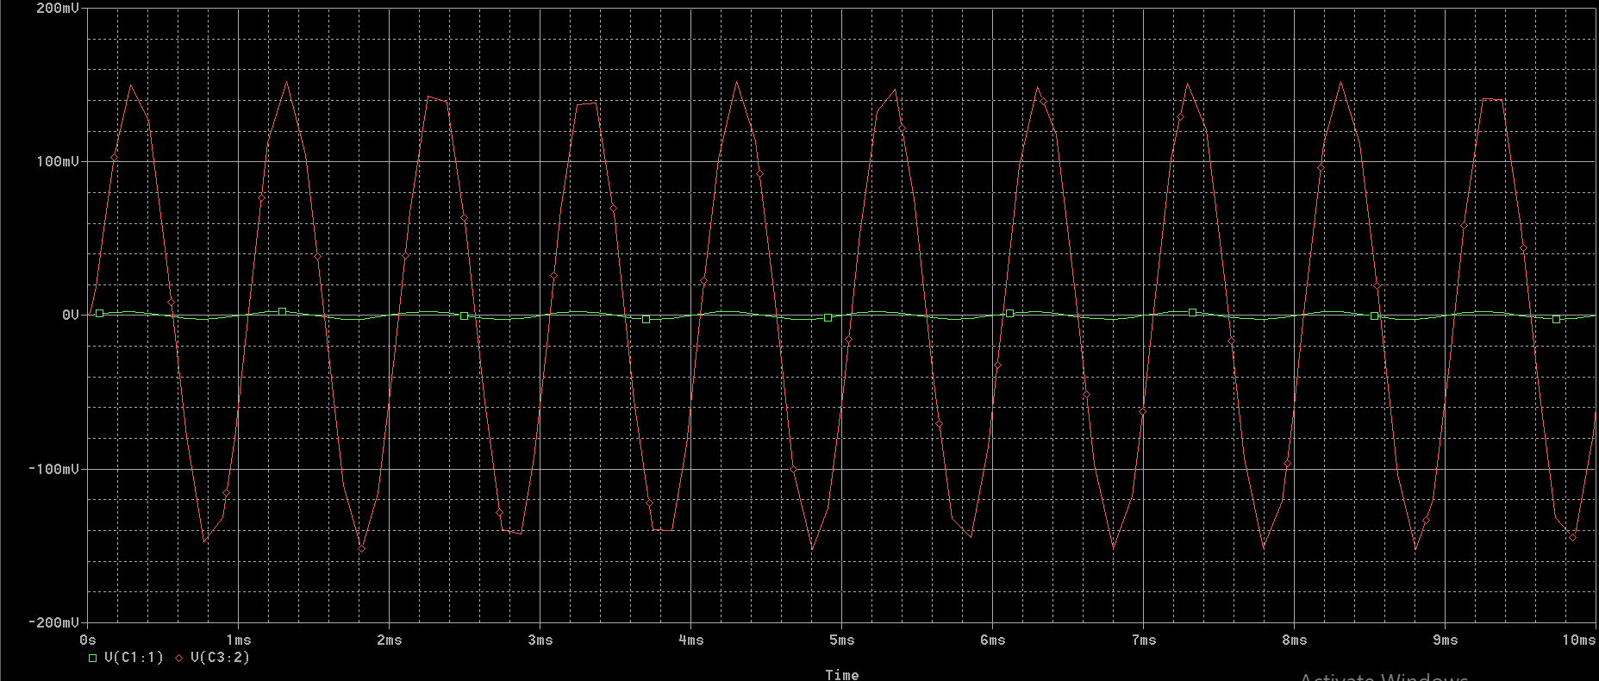
P1_2025_434A_Lungu_Jean_PAI_Capitolul5_N1_Simulator/P1_2025_434A_Lungu_Jean_PAI_N1_OrCAD/Simulations/Simularea 1.png
