LunguJean/ORCAD-Project/P1_2025_434A_Lungu_Jean_PAI_Capitolul5_N1_Simulator/P1_2025_434A_Lungu_Jean_PAI_N1_OrCAD/Data Sheet/Formule_test_UU_V2.pdf

Linii de transmisiune | Constante

γ = √(Rl + jωLl
)(Gl + jωCl

) = α + jβ

Zc = √
Rl + jωLl
Gl + jωCl

β =

2π
λ

vφ =

ω
β

= λ · f

c =

1
√(ε0εrμ0μr
)

=

c0
√εrμr

Γ =

Zs − Zc
Zs + Zc

σ =

|Umax|

|Umin|

=

1 + |Γ|
1 − |Γ|

≥ 1

Zin = Zc

Zs + jZc

tg(β ∙ l)
Zc + jZs

tg(β ∙ l)

φΓ = arctan (

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
Ll =

β

2
ω²
- Cl

[

H
m

]

Γ = |Γ| ∙ (cosx + jsinx)

λ =

c
f

l =

kλ
4

⇒ Zin =

Zc

2
Zs

, k − impar

l =

kλ
2

⇒ Zin = Zs

, k − par

Zs = Rs
{

> Zc ⇒ σ =

Rs
Zc

< Zc ⇒ σ =

Zc
Rs
= Zc ⇒ σ = 1

dmin =

π + φΓ
4π

λ + k ·

λ
2

; dmin ∊ [0,

λ
2

)

π + φΓ
4π

λ > 0 → k = 0

dmax = (

φΓ
4π

) · λ + k ·

λ
2

U(z) = Us

[cos(β · z) − j (

Zc
Zs

) · sin(β · z)]

Ps = Pd − Pi =

|Ud0

2
2Zc

−

|Ui0

2
2Zc

=

|Umax|

2
2σZc

Pi
Pd = |Γ|

2

Pd =

|Ud0

2
2Zc

; Pi =

|Ui0

2
2Zc

|Γ| = √a
2 + b

2
, a,b ∊ ℝ

√1 + x = 1 +

x
2

, x ≪ 1

ε0 = 8.854 ×

10⁻¹²F
m

μ0 = 4π ×

10⁻⁷H
m

aer: εr = 1, μr = 1

c0 = 3 ×

10⁸m
s

Z0 = 120π Ω = 377 Ω

1 Np ≅ 8.686 dB

Linie fara pierderi → Rl = 0 ; Gl = 0

## Ghid de undă

f > fcm,n = (

c
2

) · √(
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
TEm,n = Hm,n ∶ m, n ∈ ℕ; m + n ≠ 0

TMm,n = Em,n ∶ m, n ∈ ℕ

∗

λgm,n =

λ
√1 − (
fcm,n
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
(μr = 1)

λcm,n =

c

fcm,n

vfm,n =

ω
βg

=

c
√1 − (
fcm,n
f

)

2

vgm,n = c · √1 − (
fcm,n
f

)

2

(Zu

)Hm,n =

Zd
√1 − (
fcm,n
f

)

2

> Zd

(Zu

)Em,n = Zd · √1 − (
fcm,n
f

)

2
< Zd

γg = √k
2 − ω²εμ

k =

2π
λc

Zd = √

μ
ε

= √
μ0
ε0εr

=

Z0
√εr

Pmax,tr =

|E|max

2
4 (Zu

)H1,0

ab

1
σ

Pmax = Pmax,tr ∙ C
