LunguJean/ORCAD-Project/P1_2025_434A_Lungu_Jean_PAI_Capitolul5_N1_Simulator/P1_2025_434A_Lungu_Jean_PAI_N1_OrCAD/Schematics/Orcad/Proiect_APD_Lungu_Jean-PSpiceFiles/SCHEMATIC1/sim1/sim1.cir

** Profile: "SCHEMATIC1-sim1"  [ C:\Users\JEAN\Desktop\P1_2025_434A_Lungu_Jean_PAI_Capitolul5_N1_Simulator\Schematics\Orcad\proiect_apd_lungu_jean-pspicefiles\schematic1\sim1.sim ] 

** Creating circuit file "sim1.cir" 
** WARNING: THIS AUTOMATICALLY GENERATED FILE MAY BE OVERWRITTEN BY SUBSEQUENT SIMULATIONS

*Libraries: 
* Profile Libraries :
* Local Libraries :
* From [PSPICE NETLIST] section of C:\Users\JEAN\AppData\Roaming\SPB_16.6\cdssetup\OrCAD_PSpice\17.2.0\PSpice.ini file:
.lib "nomd.lib" 

*Analysis directives: 
.TRAN  0 10ms 0 
.OPTIONS ADVCONV
.PROBE64 V(alias(*)) I(alias(*)) W(alias(*)) D(alias(*)) NOISE(alias(*)) 
.INC "..\SCHEMATIC1.net" 


.END
