LunguJean/ORCAD-Project/(list of files, drawings)

Other design files:
P1_2025_434A_Lungu_Jean_PAI_Capitolul5_N1_Simulator/P1_2025_434A_Lungu_Jean_PAI_N1_OrCAD/Schematics/Etapa2/PROIECT_APD_SCHEMATIC_ANALOG.DSN
P1_2025_434A_Lungu_Jean_PAI_Capitolul5_N1_Simulator/P1_2025_434A_Lungu_Jean_PAI_N1_OrCAD/Schematics/Etapa2/proiect_apd_schematic_analog.opj
P1_2025_434A_Lungu_Jean_PAI_Capitolul5_N1_Simulator/P1_2025_434A_Lungu_Jean_PAI_N1_OrCAD/Schematics/Orcad/proiect_apd_lungu_jean.dsn
P1_2025_434A_Lungu_Jean_PAI_Capitolul5_N1_Simulator/P1_2025_434A_Lungu_Jean_PAI_N1_OrCAD/Schematics/Orcad/Proiect_APD_Lungu_Jean.opj
